AnesidoraCorporation/hh2025hardware/HH2025badge.pdf

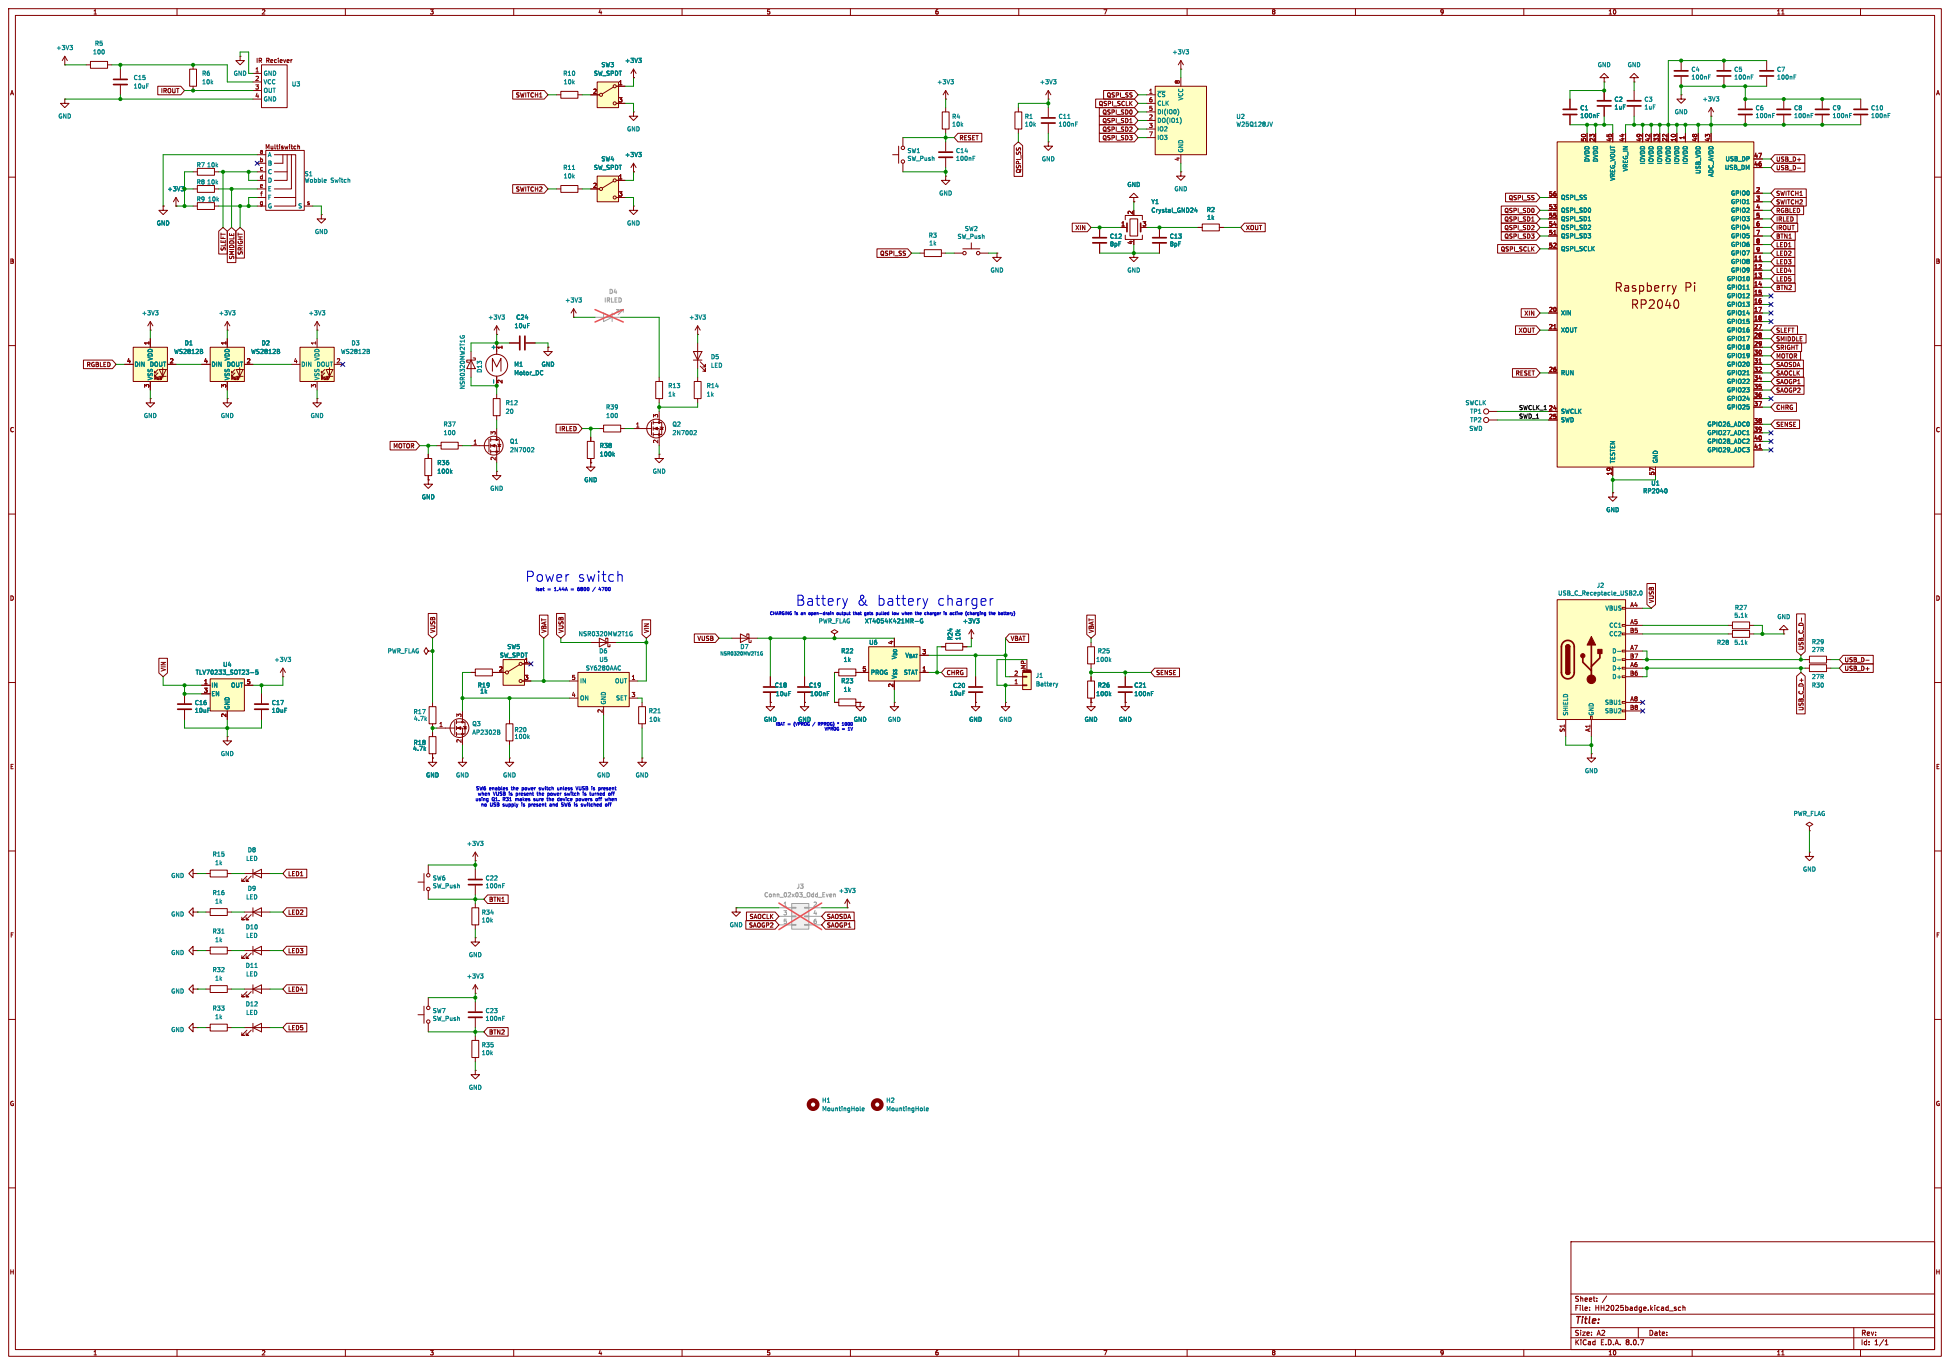
[picture p1: page 1]

SW6 enables the power switch unless VUSB is present when VUSB is present the power switch is turned off using Q1. R31 makes sure the device powers off when
