AnesidoraCorporation/hh2025hardware/HH2025badge.kicad_pcb

## KiCad design HH2025badge.kicad_pcb (2025-02-14)

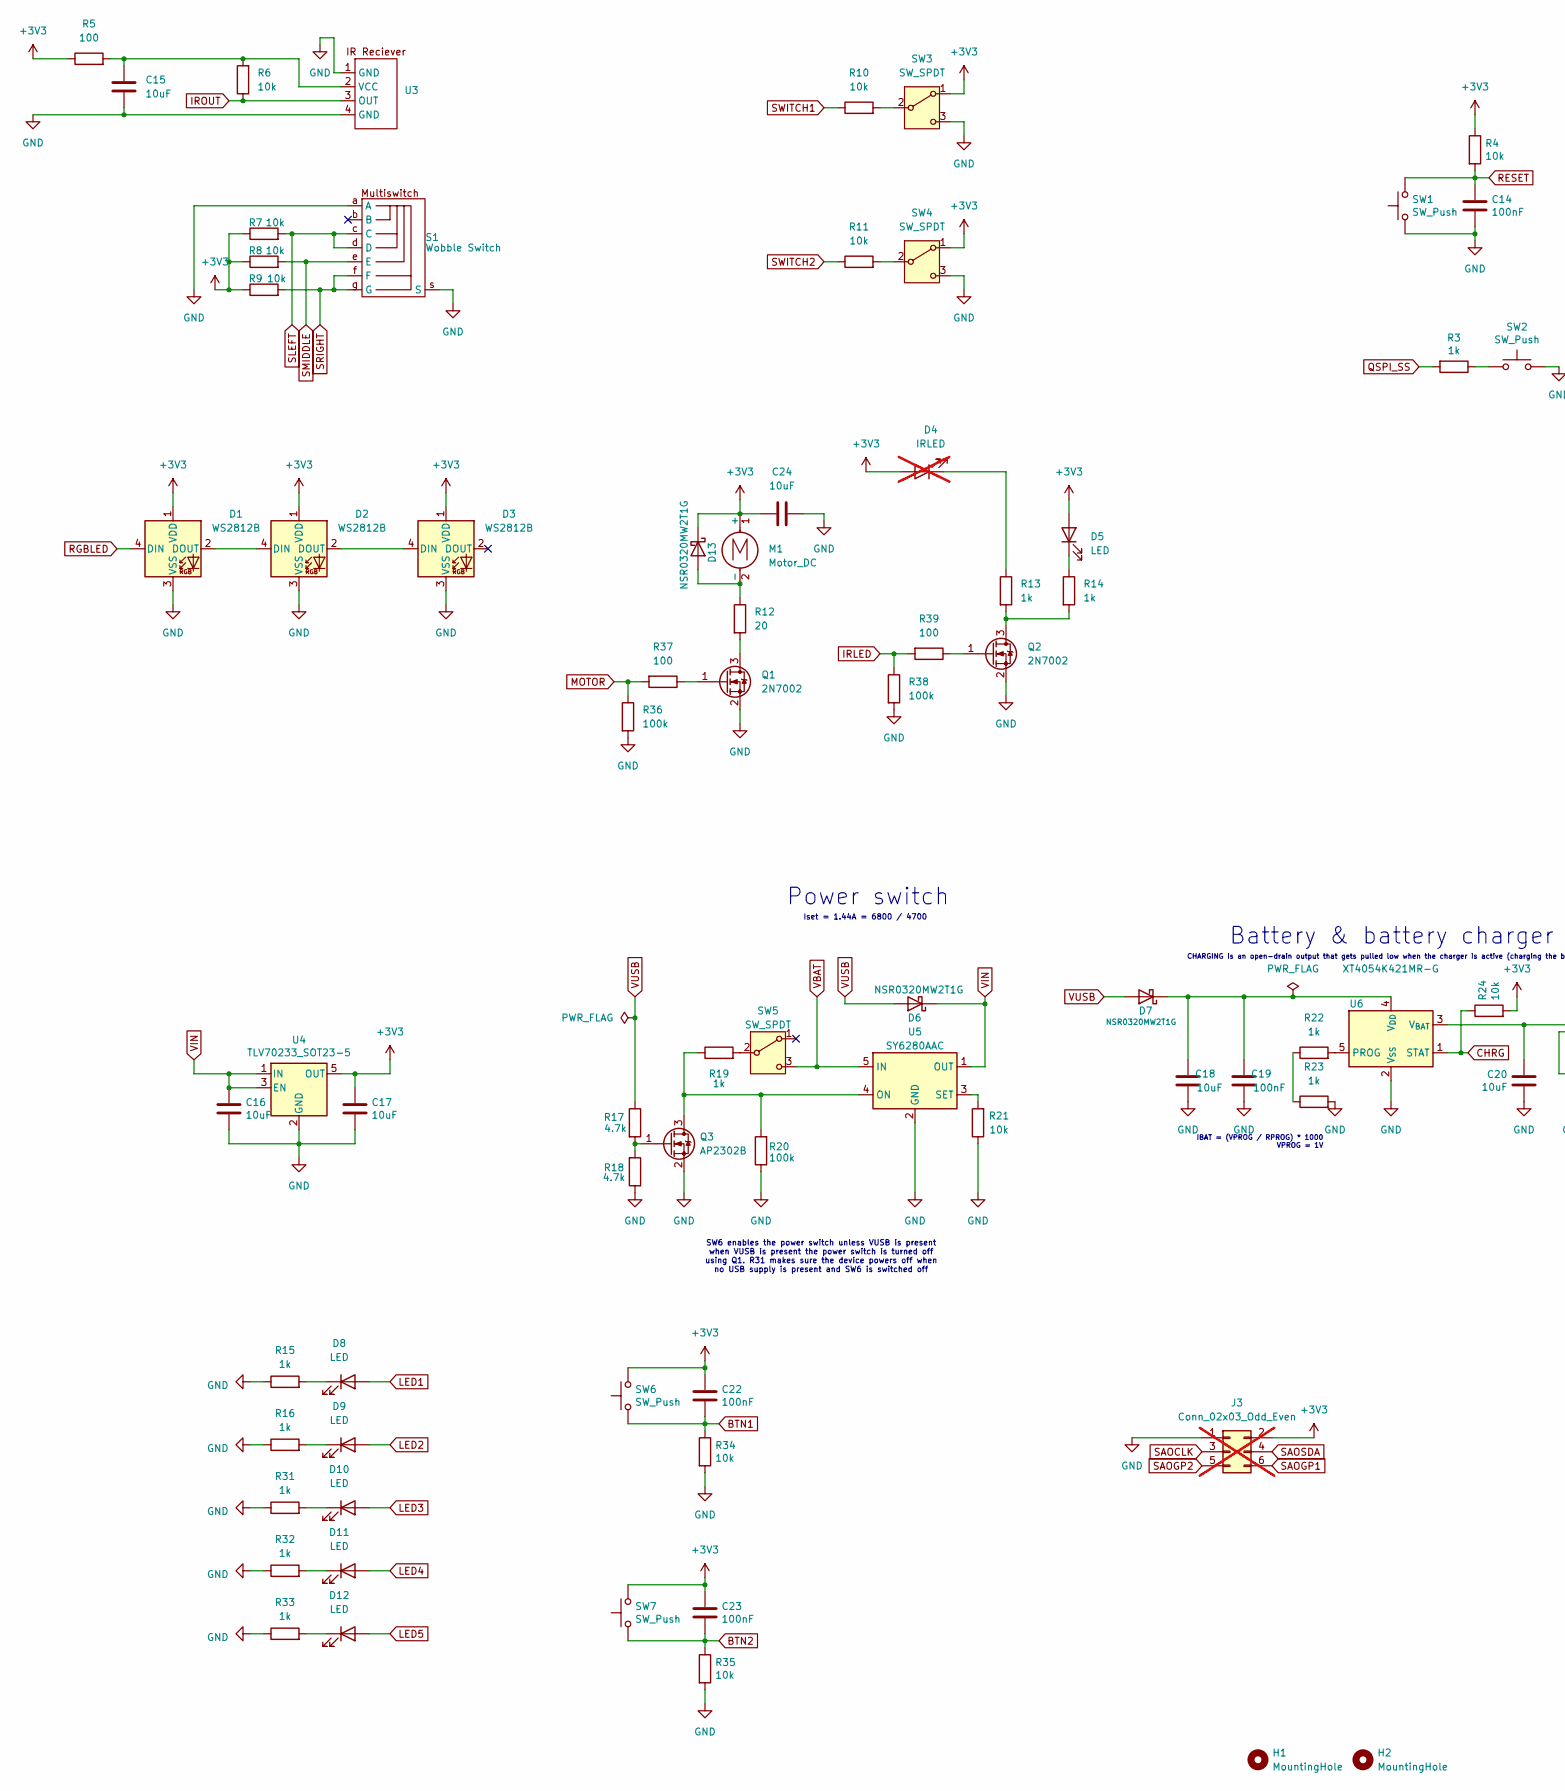
[picture p2: schematic HH2025badge.kicad_sch, part in row 1, column 1]

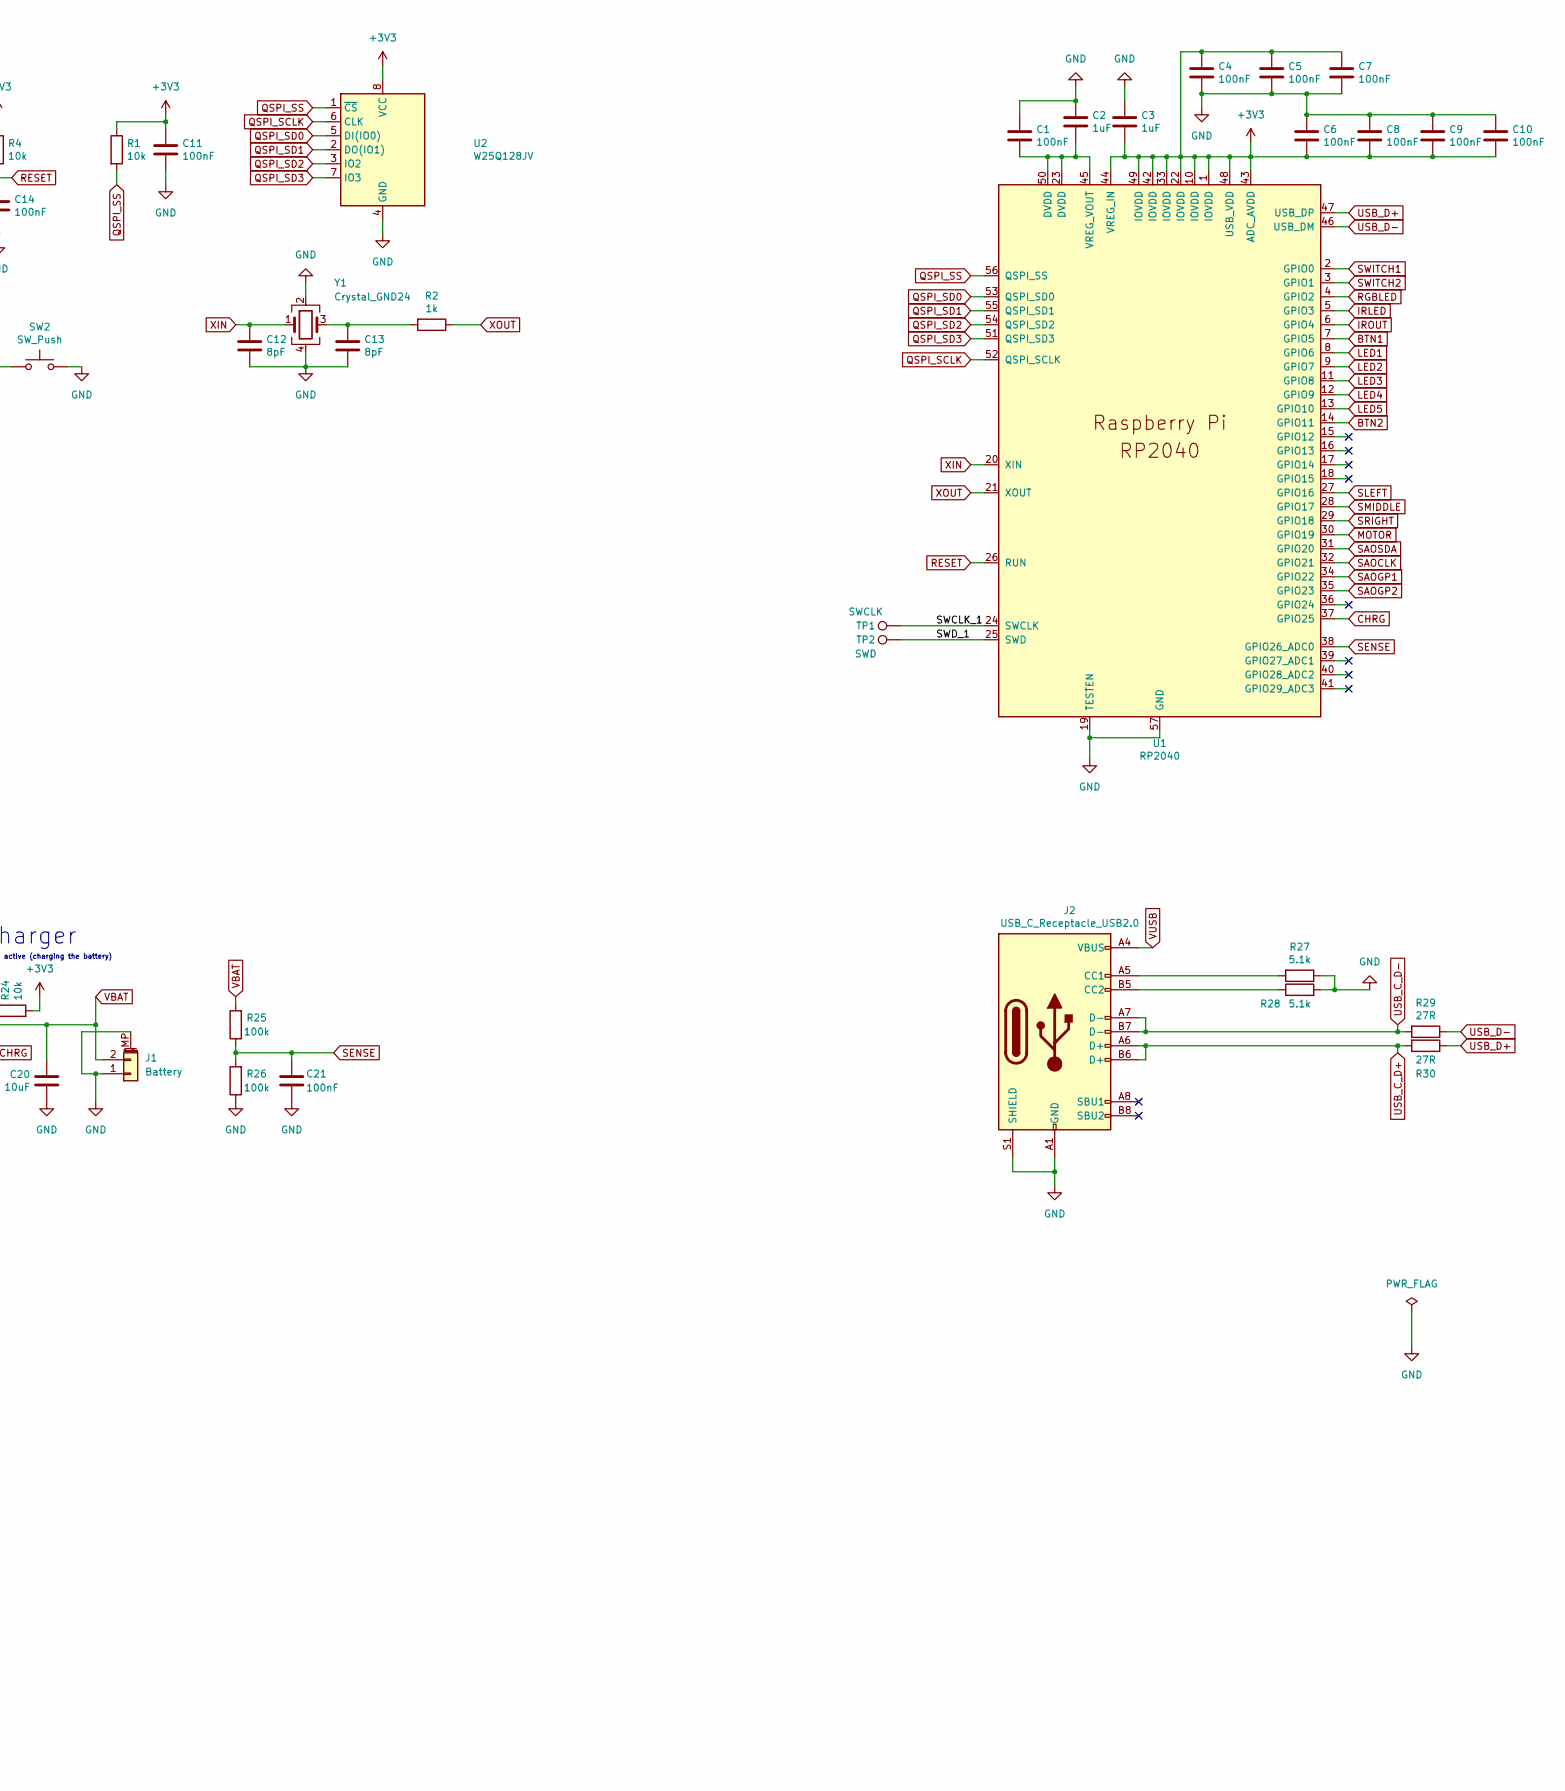
[picture p3: schematic HH2025badge.kicad_sch, part in row 1, column 2]

Parts:
C1, C4, C5, C6, C7, C8, C9, C10, C11, C14, C19, C21, C22, C23: 100nF; C_0402_1005Metric; LCSC C1525
C2, C3: 1uF; C_0402_1005Metric; LCSC C52923
C12, C13: 8pF; C_0402_1005Metric; LCSC C296006
C15, C16, C17, C18, C20, C24: 10uF; C_0805_2012Metric; LCSC C89189
D1, D2, D3: WS2812B; LED_WS2812B_PLCC4_5.0x5.0mm_P3.2mm; LCSC C4154882
D4: IRLED; LED_D5.0mm_IRGrey; LCSC DNP; not fitted
D5, D8, D9, D10, D11, D12: LED; LED_0603_1608Metric; LCSC C72038
D6, D7, D13: NSR0320MW2T1G; D_SOD-323; LCSC C48192
H1, H2: MountingHole; MountingHole_3.2mm_M3; LCSC DNP
J1: Battery; JST_S2B-ZR-SM4A-TF(LF)(SN); LCSC C2681533
J2: USB_C_Receptacle_USB2.0; USB_C_Receptacle_HRO_TYPE-C-31-M-12; LCSC C167321
J3: Conn_02x03_Odd_Even; PinHeader_2x03_P2.54mm_Vertical; LCSC DNP; not fitted
M1: Motor_DC; PinHeader_1x02_P2.54mm_Vertical; LCSC DNP
Q1, Q2: 2N7002; SOT-23; LCSC C389059
Q3: AP2302B; SOT-23; LCSC C406812
R1, R4, R6, R7, R8, R9, R10, R11, R21, R24, R34, R35: 10k; R_0402_1005Metric; LCSC C25744
R2, R3, R13, R14, R15, R16, R19, R22, R23, R31, R32, R33: 1k; R_0402_1005Metric; LCSC C11702
R5, R37, R39: 100; R_0805_2012Metric; LCSC C17408
R12: 20; R_0805_2012Metric; LCSC C212359
R17, R18: 4.7k; R_0805_2012Metric; LCSC C2907326
R20, R25, R26, R36, R38: 100k; R_0402_1005Metric; LCSC C25741
R27, R28: 5.1k; R_0402_1005Metric; LCSC C25905
R29, R30: 27R; R_0402_1005Metric; LCSC C25100
S1: Wobble Switch; SW-SMD_TM-1011A; LCSC C318960
SW1, SW2, SW6, SW7: SW_Push; SW_SPST_TL3305A; LCSC C92581
SW3, SW4, SW5: SW_SPDT; SW_SPDT_PCM12; LCSC C319020
TP1: SWCLK; TestPoint_Pad_D1.0mm; LCSC DNP
TP2: SWD; TestPoint_Pad_D1.0mm; LCSC DNP
U1: RP2040; RP2040-QFN-56; LCSC C2040
U2: W25Q128JV; SOIC-8_5.23x5.23mm_P1.27mm; LCSC C97521
U3: OPTO-SMD_IRM-V838M3-C-TR1; LCSC C3291489
U4: TLV70233_SOT23-5; SOT-23-5; LCSC C118233
U5: SY6280AAC; SOT-23-5; LCSC C55136
U6: XT4054K421MR-G; SOT-23-5; LCSC C141405
Y1: Crystal_GND24; Crystal_SMD_3225-4Pin_3.2x2.5mm; LCSC C255902

Connections:
+3V3: C3.2, C4.1, C5.1, C6.2, C7.1, C8.2, C9.2, C10.2, C11.1, C17.1, C22.1, C23.1, C24.1, D1.1 (VDD), D2.1 (VDD), D3.1 (VDD), D4.2 (A), D5.2 (A), D13.1 (K), J3.2, M1.1 (+), R1.1, R4.1, R5.1, R7.1, R8.1, R9.1, R24.2, SW3.1 (A), SW4.1 (A), SW6.2, SW7.2, U1.1 (IOVDD), U1.10 (IOVDD), U1.22 (IOVDD), U1.33 (IOVDD), U1.42 (IOVDD), U1.43 (ADC_AVDD), U1.44 (VREG_IN), U1.48 (USB_VDD), U1.49 (IOVDD), U2.8 (VCC), U4.5 (OUT)
/SWCLK_1: TP1.1, U1.24 (SWCLK)
/SWD_1: TP2.1, U1.25 (SWD)
BTN1: C22.2, R34.1, SW6.1, U1.7 (GPIO5)
BTN2: C23.2, R35.1, SW7.1, U1.14 (GPIO11)
CHRG: R24.1, U1.37 (GPIO25), U6.1 (STAT)
GND: C1.1, C2.1, C3.1, C4.2, C5.2, C6.1, C7.2, C8.1, C9.1, C10.1, C11.2, C12.2, C13.2, C14.2, C15.2, C16.2, C17.2, C18.1, C19.1, C20.2, C21.2, C24.2, D1.3 (VSS), D2.3 (VSS), D3.3 (VSS), J1.1, J1.MP (MountPin), J2.A1 (GND), J2.A12 (GND), J2.B1 (GND), J2.B12 (GND), J2.S1 (SHIELD), J3.1, Q1.2 (S), Q2.2 (S), Q3.2 (S), R15.1, R16.1, R18.1, R20.1, R21.1, R23.2, R26.1, R27.1, R28.2, R31.1, R32.1, R33.1, R34.2, R35.2, R36.2, R38.2, S1.a (A), S1.s (S), SW1.1, SW2.2, SW3.3 (C), SW4.3 (C), U1.19 (TESTEN), U1.57 (GND), U2.4 (GND), U3.1 (GND), U3.4 (GND), U4.2 (GND), U5.2 (GND), U6.2 (V_{SS}), Y1.2, Y1.4
IRLED: R38.1, R39.2, U1.5 (GPIO3)
IROUT: R6.1, U1.6 (GPIO4), U3.3 (OUT)
LED1: D8.2 (A), U1.8 (GPIO6)
LED2: D9.2 (A), U1.9 (GPIO7)
LED3: D10.2 (A), U1.11 (GPIO8)
LED4: D11.2 (A), U1.12 (GPIO9)
LED5: D12.2 (A), U1.13 (GPIO10)
MOTOR: R36.1, R37.2, U1.30 (GPIO19)
unnamed: C13.1, R2.2, Y1.3
unnamed: D1.2 (DOUT), D2.4 (DIN)
unnamed: D2.2 (DOUT), D3.4 (DIN)
unnamed: D4.1 (K), R13.1
unnamed: D5.1 (K), R14.1
unnamed: C18.2, C19.2, D7.1 (K), U6.4 (V_{DD})
unnamed: D8.1 (K), R15.2
unnamed: D9.1 (K), R16.2
unnamed: D10.1 (K), R31.2
unnamed: D11.1 (K), R32.2
unnamed: D12.1 (K), R33.2
unnamed: D13.2 (A), M1.2 (-), R12.1
unnamed: J2.A5 (CC1), R27.2
unnamed: J2.B5 (CC2), R28.1
unnamed: Q1.3 (D), R12.2
unnamed: Q1.1 (G), R37.1
unnamed: Q2.3 (D), R13.2, R14.2
unnamed: Q2.1 (G), R39.1
unnamed: Q3.3 (D), R19.1, R20.2, U5.4 (ON)
unnamed: Q3.1 (G), R17.2, R18.2
unnamed: R3.1, SW2.1
unnamed: R22.1, R23.1
unnamed: R10.2, SW3.2 (B)
unnamed: R11.2, SW4.2 (B)
unnamed: R19.2, SW5.2 (B)
unnamed: C1.2, C2.2, U1.23 (DVDD), U1.45 (VREG_VOUT), U1.50 (DVDD)
unnamed: C15.1, R5.2, R6.2, U3.2 (VCC)
unnamed: R21.2, U5.3 (SET)
unnamed: R22.2, U6.5 (PROG)
QSPI_SCLK: U1.52 (QSPI_SCLK), U2.6 (CLK)
QSPI_SD0: U1.53 (QSPI_SD0), U2.5 (DI(IO0))
QSPI_SD1: U1.55 (QSPI_SD1), U2.2 (DO(IO1))
QSPI_SD2: U1.54 (QSPI_SD2), U2.3 (IO2)
QSPI_SD3: U1.51 (QSPI_SD3), U2.7 (IO3)
QSPI_SS: R1.2, R3.2, U1.56 (QSPI_SS), U2.1 (~CS)
RESET: C14.1, R4.2, SW1.2, U1.26 (RUN)
RGBLED: D1.4 (DIN), U1.4 (GPIO2)
SAOCLK: J3.3, U1.32 (GPIO21)
SAOGP1: J3.6, U1.34 (GPIO22)
SAOGP2: J3.5, U1.35 (GPIO23)
SAOSDA: J3.4, U1.31 (GPIO20)
SENSE: C21.1, R25.1, R26.2, U1.38 (GPIO26_ADC0)
SLEFT: R7.2, S1.c (C), S1.d (D), U1.27 (GPIO16)
SMIDDLE: R8.2, S1.e (E), U1.28 (GPIO17)
SRIGHT: R9.2, S1.f (F), S1.g (G), U1.29 (GPIO18)
SWITCH1: R10.1, U1.2 (GPIO0)
SWITCH2: R11.1, U1.3 (GPIO1)
USB_C_D+: J2.A6 (D+), J2.B6 (D+), R30.2
USB_C_D-: J2.A7 (D-), J2.B7 (D-), R29.2
USB_D+: R30.1, U1.47 (USB_DP)
USB_D-: R29.1, U1.46 (USB_DM)
VBAT: C20.1, J1.2, R25.2, SW5.3 (C), U5.5 (IN), U6.3 (V_{BAT})
VIN: C16.1, D6.1 (K), U4.1 (IN), U4.3 (EN), U5.1 (OUT)
VUSB: D6.2 (A), D7.2 (A), J2.A4 (VBUS), J2.A9 (VBUS), J2.B4 (VBUS), J2.B9 (VBUS), R17.1
XIN: C12.1, U1.20 (XIN), Y1.1
XOUT: R2.1, U1.21 (XOUT)

Notes on the sheet:
Iset = 1.44A = 6800 / 4700
IBAT = (VPROG / RPROG) * 1000 VPROG = 1V
Battery & battery charger
Power switch
SW6 enables the power switch unless VUSB is present when VUSB is present the power switch is turned off using Q1. R31 makes sure the device powers off when no USB supply is present and SW6 is switched off
CHARGING is an open-drain output that gets pulled low when the charger is active (charging the battery)

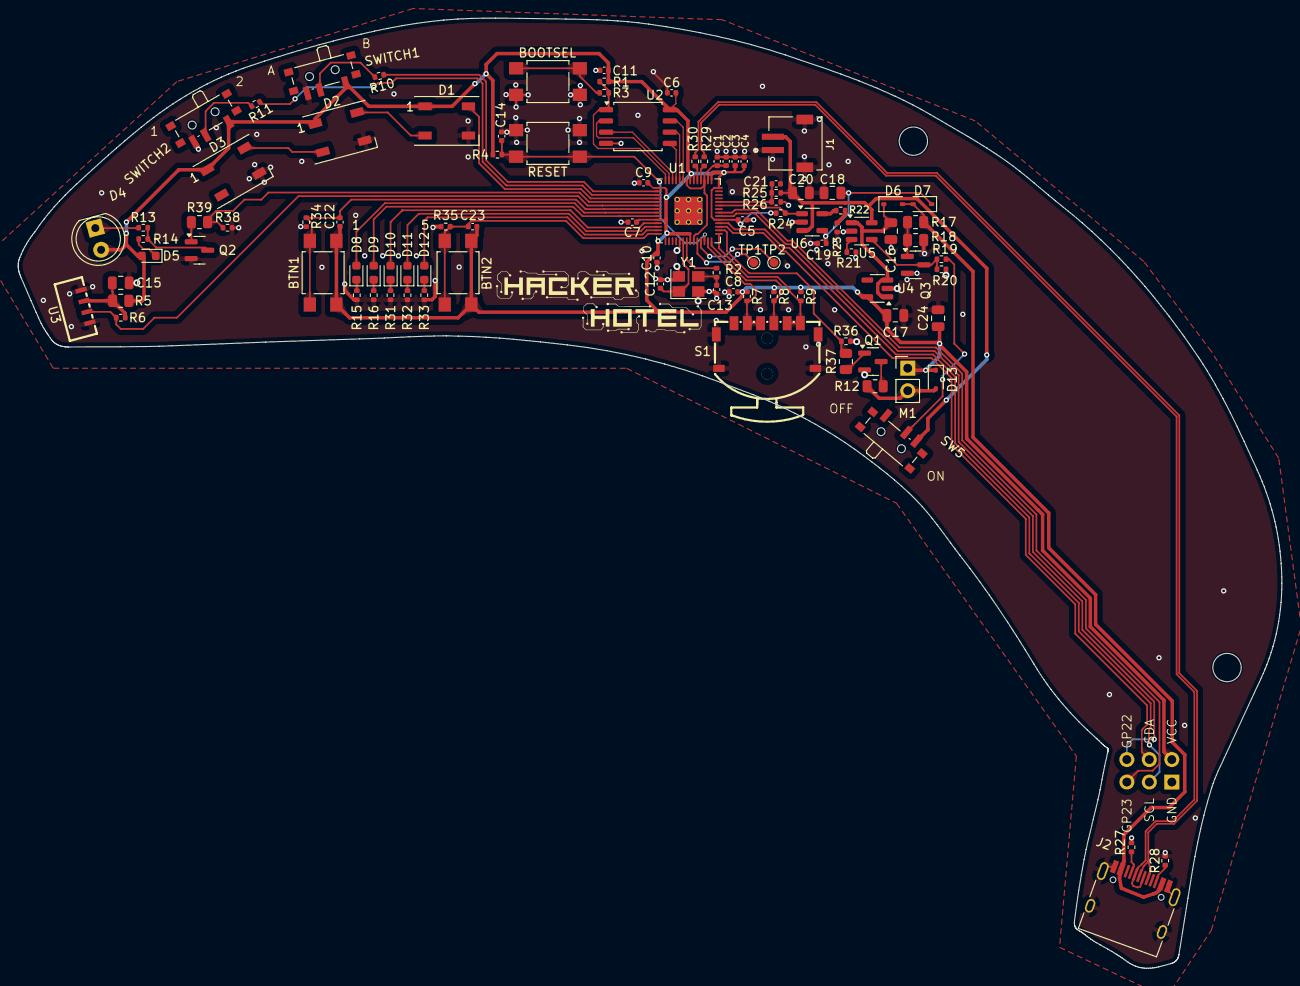
[picture p4: board HH2025badge.kicad_pcb from above]

Board: 2 copper layers, 142.7 x 107.3 mm, 102 parts (1 on the bottom side), 71 nets.
