AnesidoraCorporation/hh2025hardware/(commit log)

2025-02-13 Uploaded schematic
2025-02-14 Added all production files
    [HH2025badge-B_Cu.gbr, HH2025badge-B_Mask.gbr, HH2025badge-B_Paste.gbr, HH2025badge-B_Silkscreen.gbr, HH2025badge-Edge_Cuts.gbr, HH2025badge-F_Cu.gbr, HH2025badge-F_Mask.gbr, HH2025badge-F_Paste.gbr]
